WeatherWaterClimateServices/wwcs/WWCS/ews/README.md

# Parameterization in the SitesHumans.Sites table
'{"Heat1": 25, "Heat2": 27, "Heat3": 29, "Cold1": 0, "Cold2": -5, "Cold3": -10, "Warn Altitude": 3000}'
