WeatherWaterClimateServices/wwcs/WWCS/irrigation/appdata/Potato/README.md

Kc.csv - these are the Kc used in the very first Excel from ICARDA. They are currently used within the WWCS system.

The excels for plot 3 are more recent. Their Kcs corresond to a shorter growing period. Information from these files is not in the WWCS system so far, they are kept for information.
