WeatherWaterClimateServices/wwcs/WWCS/home/www/api-small.png

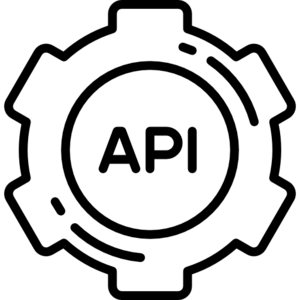
WWCS/home/www/api-small.png
