WeatherWaterClimateServices/wwcs/WWCS/home/www/api_small_border.png

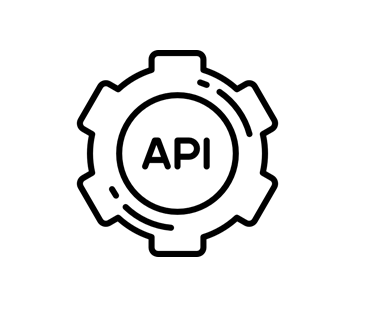
WWCS/home/www/api_small_border.png
