WeatherWaterClimateServices/wwcs/WWCS/home/www/cold-wave-small.png

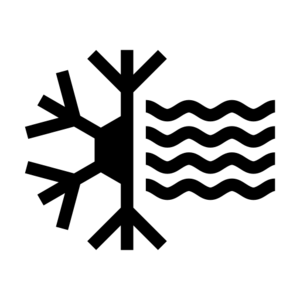
WWCS/home/www/cold-wave-small.png
