WeatherWaterClimateServices/wwcs/WWCS/home/www/harvest-small.png

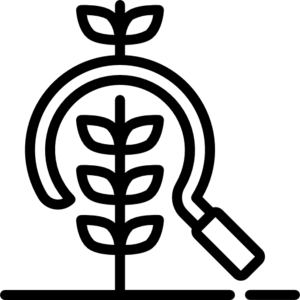
WWCS/home/www/harvest-small.png
