WeatherWaterClimateServices/wwcs/WWCS/home/www/monitor-small.png

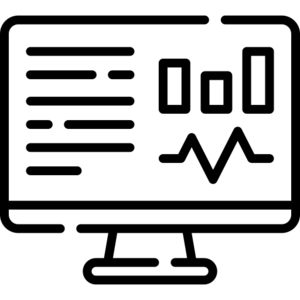
WWCS/home/www/monitor-small.png
