WeatherWaterClimateServices/wwcs/WWCS/home/www/planting-small.png

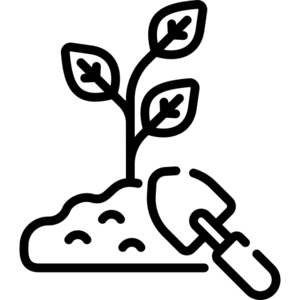
WWCS/home/www/planting-small.png
