WeatherWaterClimateServices/wwcs/WWCS/home/www/water-system-small.png

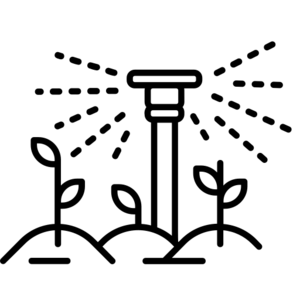
WWCS/home/www/water-system-small.png
