WeatherWaterClimateServices/wwcs/WWCS/irrigation/appdata/Cotton/Growing cycle Cotton Page 106 FAO56.png

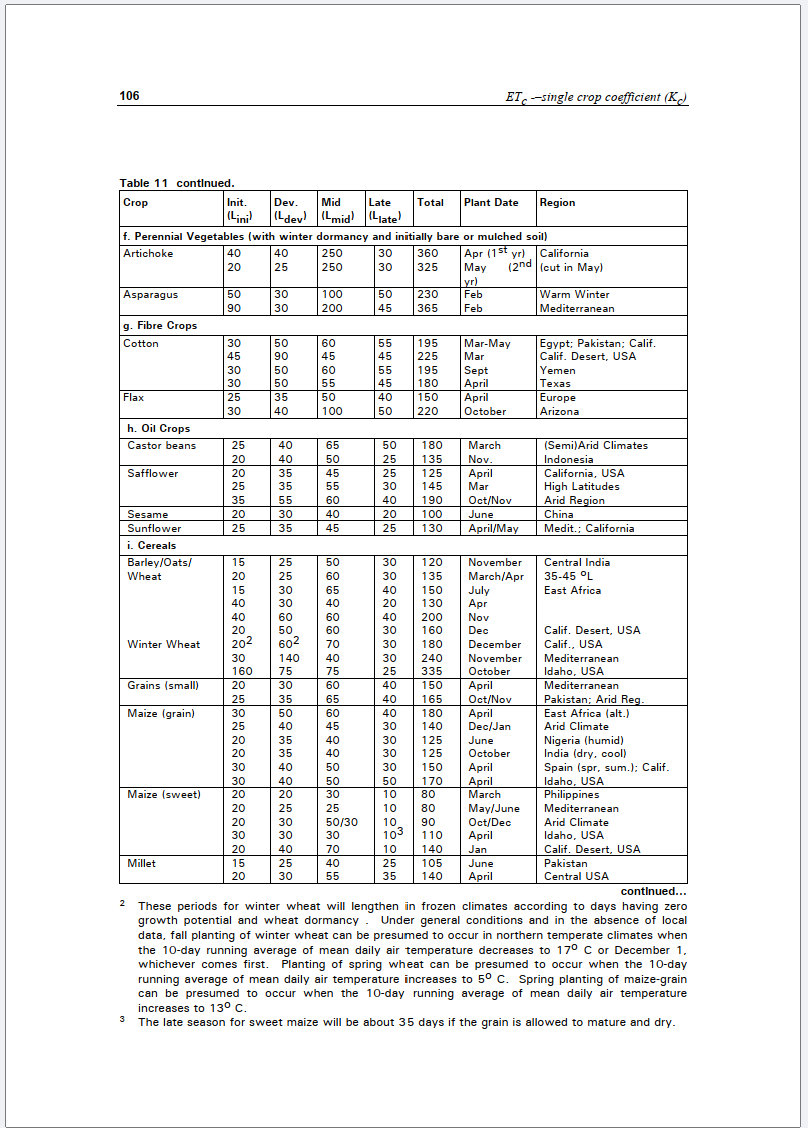
WWCS/irrigation/appdata/Cotton/Growing cycle Cotton Page 106 FAO56.png
