WeatherWaterClimateServices/wwcs/WWCS/irrigation/appdata/Cotton/Max rooting depth Cotton FAO 56.png

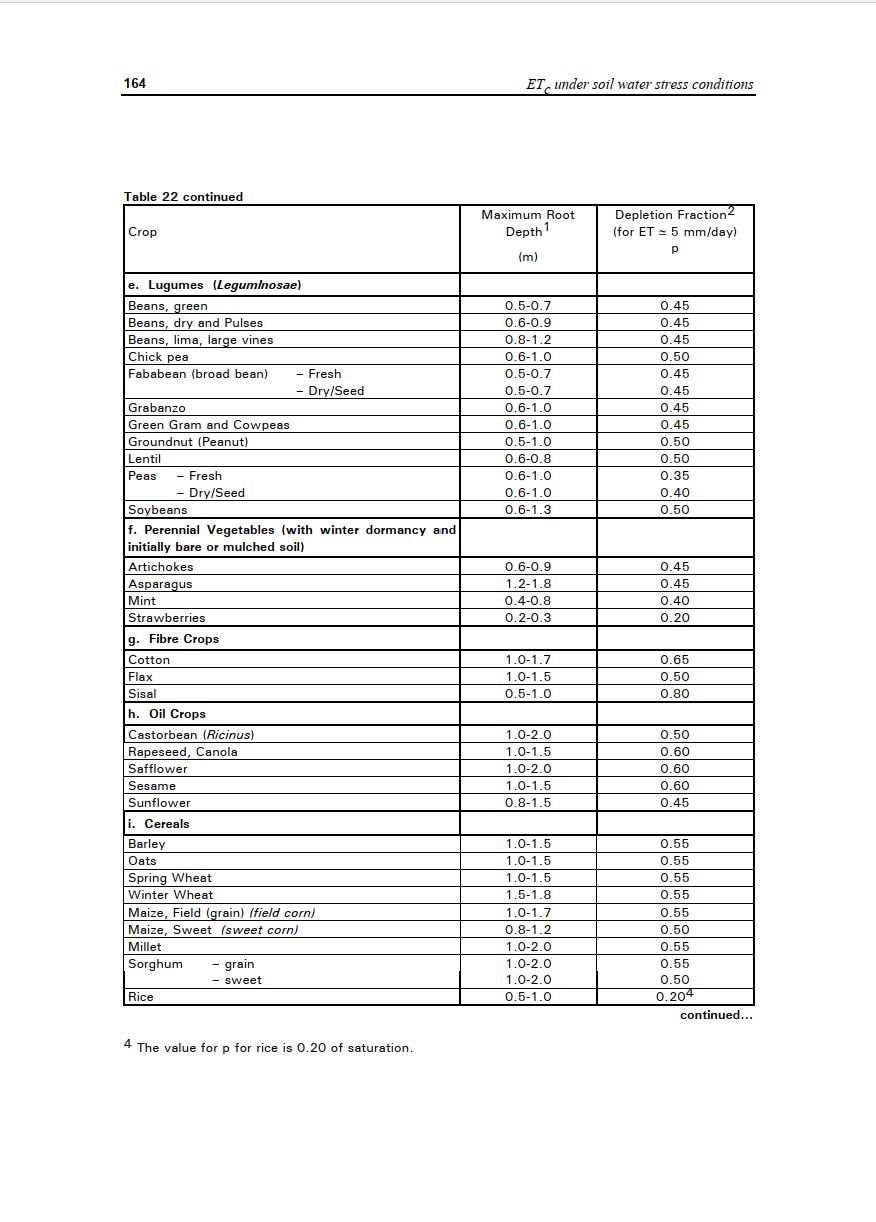
WWCS/irrigation/appdata/Cotton/Max rooting depth Cotton FAO 56.png
