WeatherWaterClimateServices/wwcs/WWCS/irrigation/appdata/Cotton/Page 111 FAO56.png

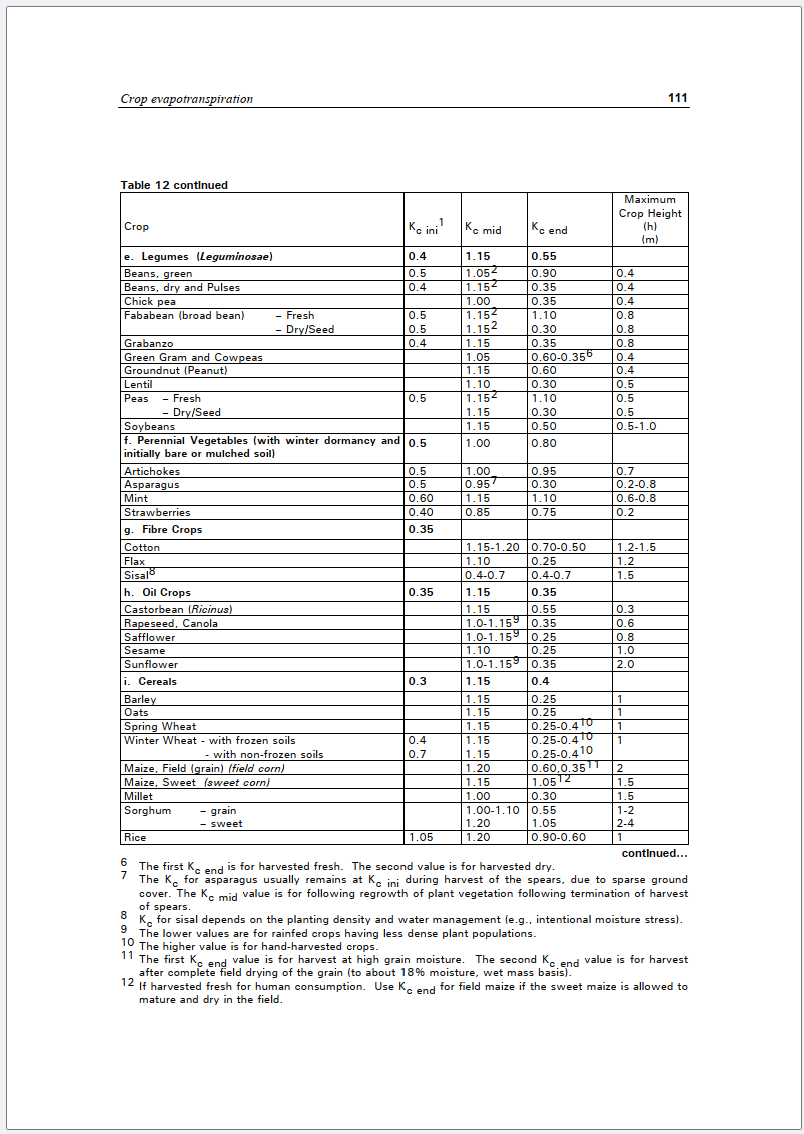
WWCS/irrigation/appdata/Cotton/Page 111 FAO56.png
