WeatherWaterClimateServices/wwcs/WWCS/irrigation/appdata/WinterWheat/Kc Winter Wheat .png

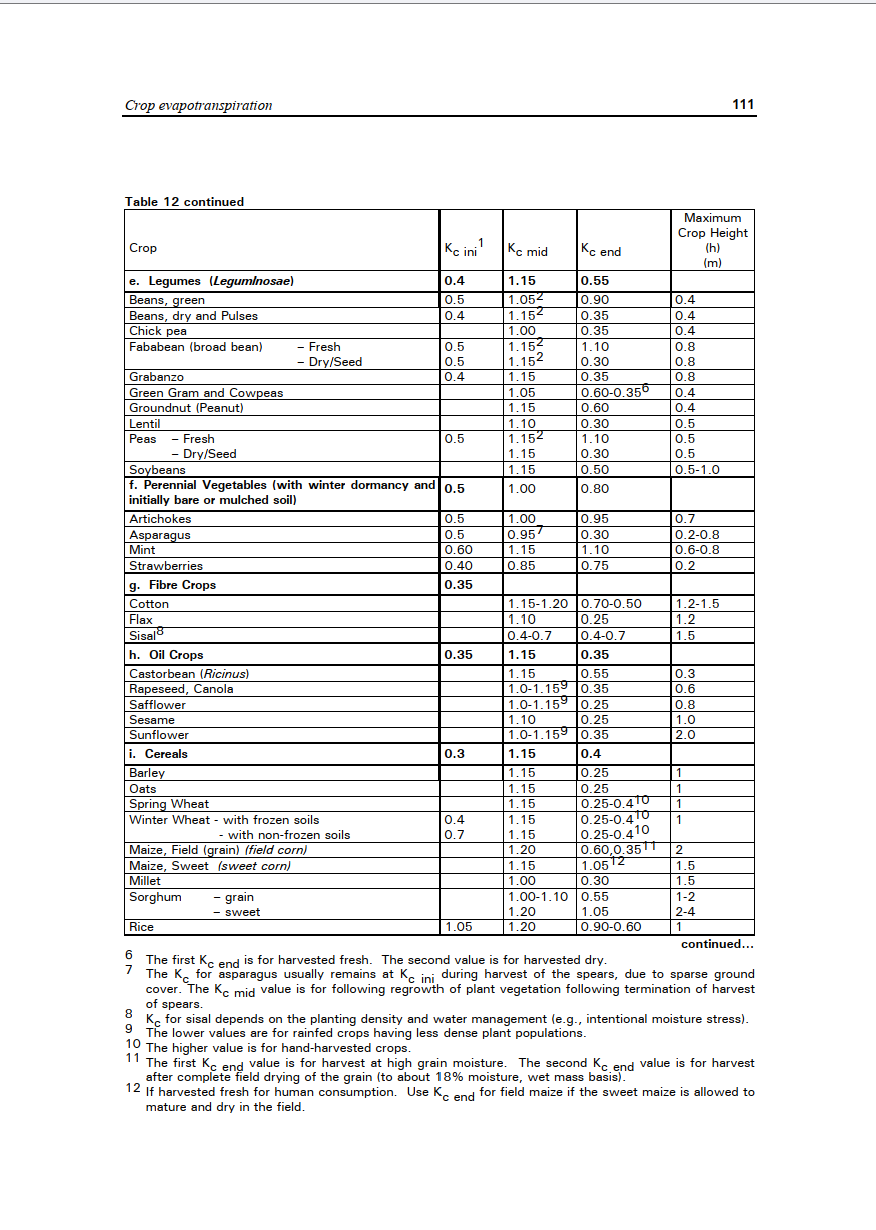
WWCS/irrigation/appdata/WinterWheat/Kc Winter Wheat .png
