WeatherWaterClimateServices/wwcs/WWCS/irrigation/appdata/WinterWheat/Max rooting depth Winter Wheat FAO56.png

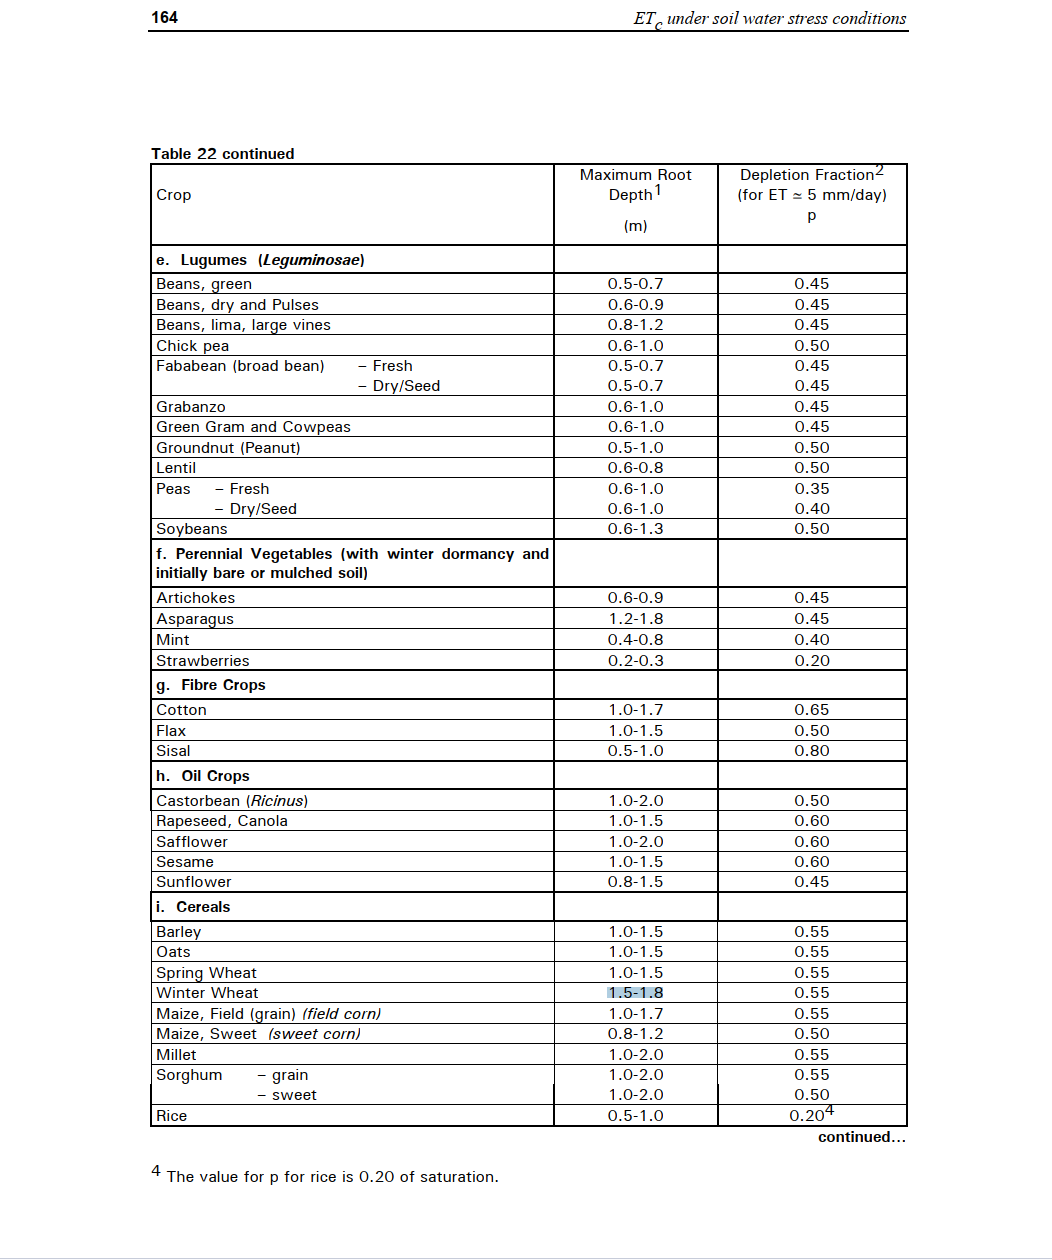
WWCS/irrigation/appdata/WinterWheat/Max rooting depth Winter Wheat FAO56.png
