WeatherWaterClimateServices/wwcs/WWCS/irrigation/appdata/WinterWheat/Max rooting depth Winter Wheat.png

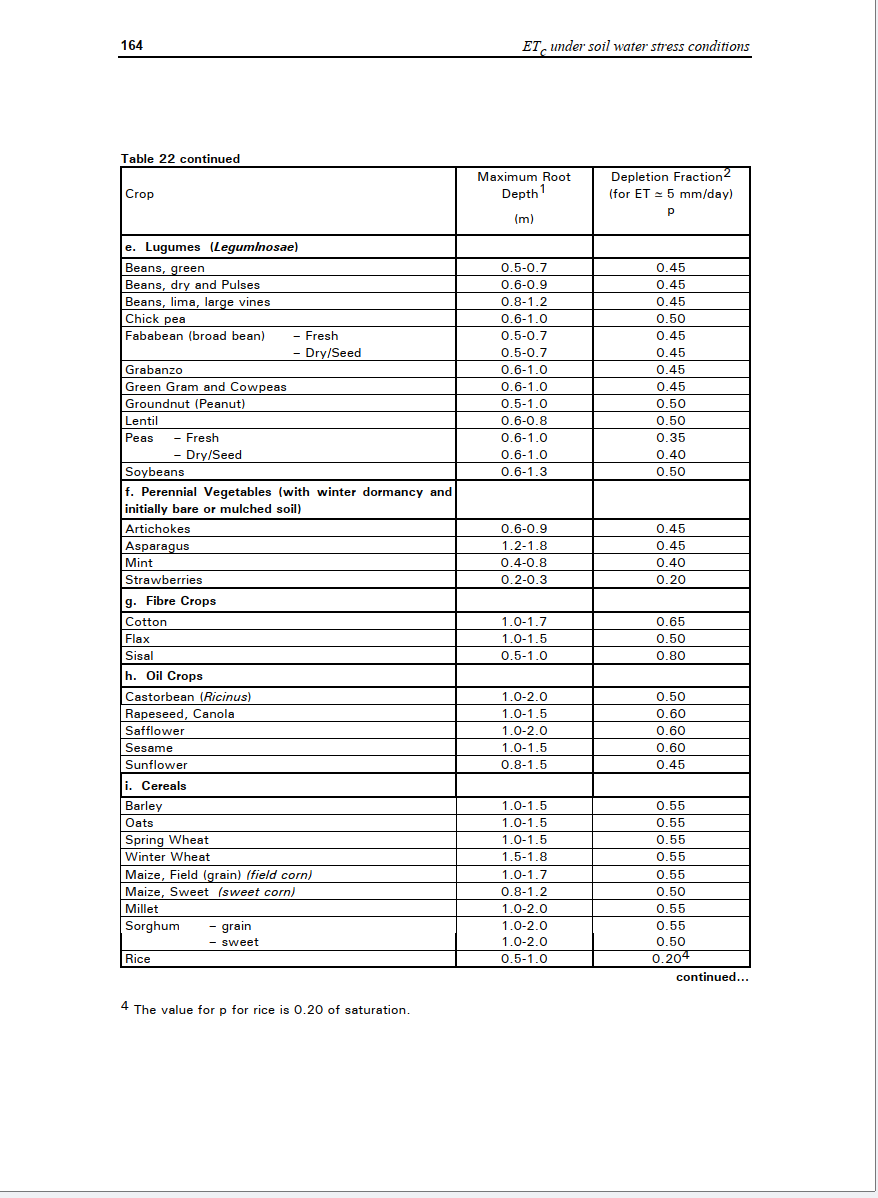
WWCS/irrigation/appdata/WinterWheat/Max rooting depth Winter Wheat.png
