WeatherWaterClimateServices/wwcs/Experimental/uploads/274c11eaea23f99c8101f92d145a69b3/solder_small.jpg

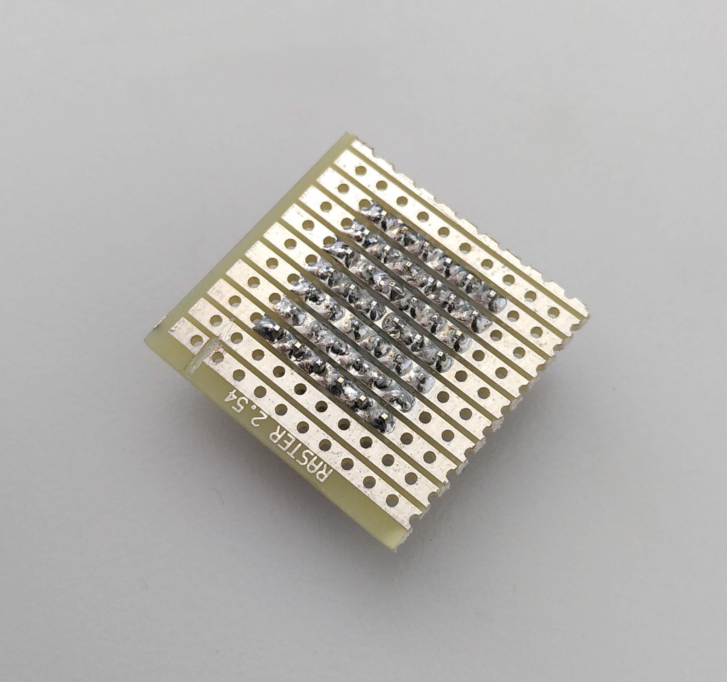
Experimental/uploads/274c11eaea23f99c8101f92d145a69b3/solder_small.jpg
