WeatherWaterClimateServices/wwcs/Experimental/uploads/756d3ad89f2d58e4a3ba79fbf11e7016/solder.jpg

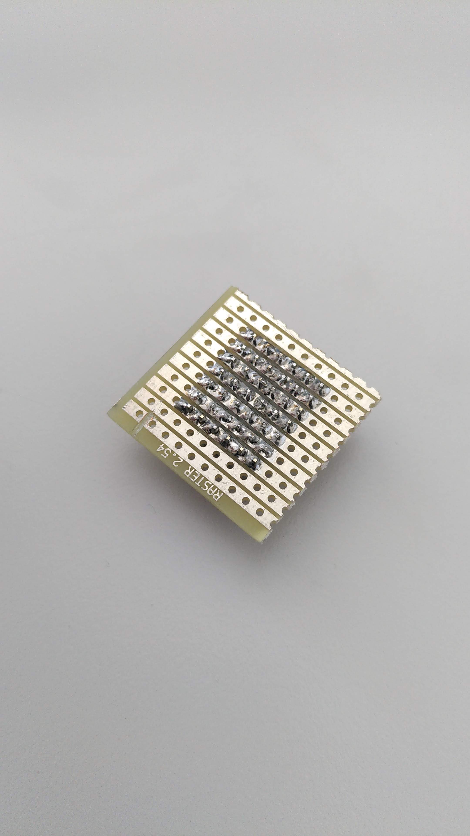
Experimental/uploads/756d3ad89f2d58e4a3ba79fbf11e7016/solder.jpg
