WeatherWaterClimateServices/wwcs/Experimental/README.md

This folder contains documentation and code for additional low-cost sensors, together with some early testing. These developments have been done by @bonamyr during work at SLF.
