WeatherWaterClimateServices/wwcs/Experimental/uploads/9176adec232814393722900b84b2ac1f/wwcs_devops_28032022.pptx

## Architecture

WWCS DevOps Meeting

Stations

WWC Services

Citizen Observations

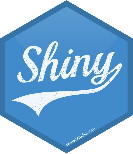
[picture p78: figure]
Shiny - R package | BIII
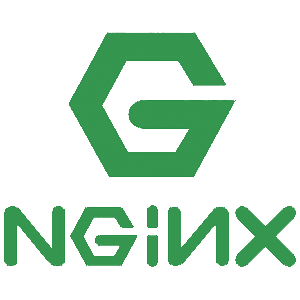
[picture p79: figure]
Nginx Web Server | Linux Destek Sunucu Yönetimi Danışmanlık & Eğitim
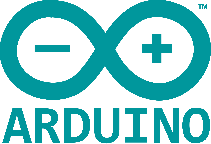
[picture p80: figure]
Datei:Arduino Logo.svg – Wikipedia

Frontend

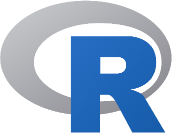
[picture p81: figure]
R (Programmiersprache) – Wikipedia
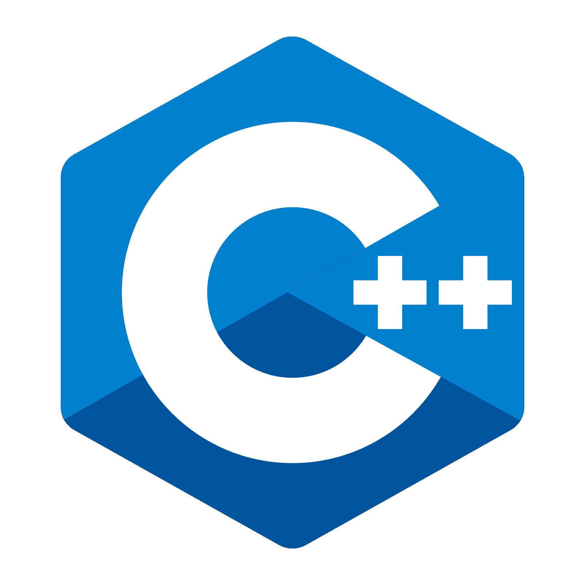
[picture p82: figure]
CONZEPT 16 C++-Schnittstelle - vectorsoft
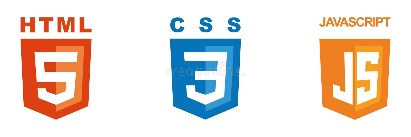
[picture p83: figure]
Ikonensatz HTML5 CSS3 JS Web-Entwicklungs-Logo-Ikonensatz HTML, Css Und Javascript, Programmierungssymbol Vektor Abbildung - Illustration von programmierung, java: 154897294
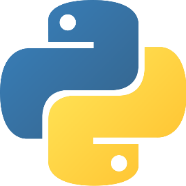
[picture p84: figure]
Datei:Python-logo-notext.svg – Wikipedia

Backend

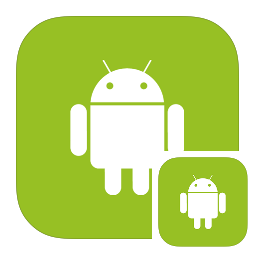
[picture p85: figure]
java - Strange app icon duplication in pinned shortcut (Android O) - Stack Overflow

API

API

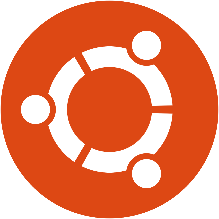
[picture p86: figure]
File:Logo-ubuntu cof-orange-hex.svg - Wikimedia Commons
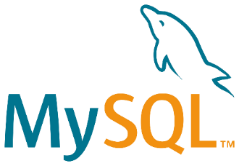
[picture p87: figure]
MySQL – Wikipedia
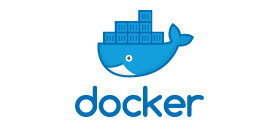
[picture p88: figure]
Was ist Docker? | AWS

Server

## Slide 2

WWC Services

| Dashboard | Kiosk | Maintenance Tool
Purpose | Check operations and identify problems of stations. Provide WWCS Services in a dashboard optimized for desktop computer. | Provide WWCS at district level in collaboration with agricultural advisors optimized for cash machine devices | Manage the deployment and maintenance of stations optimized for mobile devices.
Software | C++ for station processing Python + R for calculations based on MeteoSwiss scripts. R-Shiny to visualize the dashboard | Python + Microsoft Forms | Python + HTML (bootstrap) + JS
Focal Points | Omar, Mathias | Kushbakht, Safarali | Kushbakht, Safarali
Snapshot

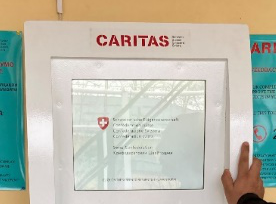
[picture p89: figure]
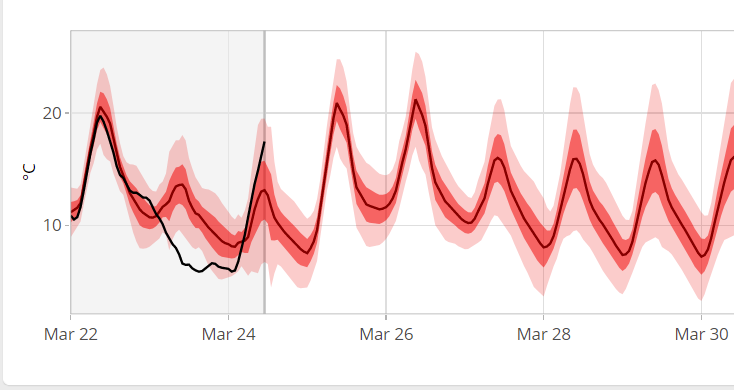
[picture p90: figure]
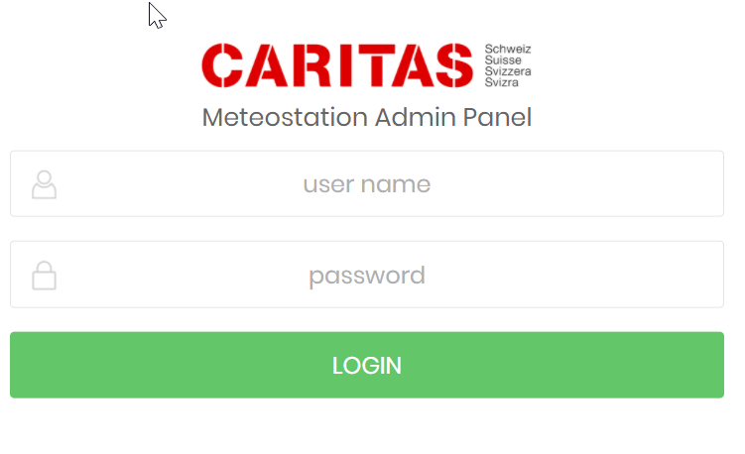
[picture p91: figure]

## Slide 3

Station Monitoring

Station Monitoring

WSL GitLab

Current Structure

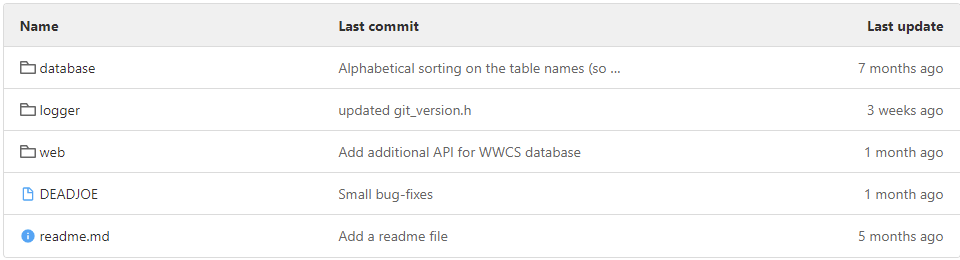
[picture p92: figure]

Kiosk

Proposed changes
1. Rename «logger» to «stations» to include also python scripts
2. Add folder «citizen» with the application that pushes the sms data
3. Rename «web» with «services»
Inside «services»:
  - «dashboard»
  - «kiosk»
  - «maintenance»
  - «API»
4. Create a «Dockerfile» for the container

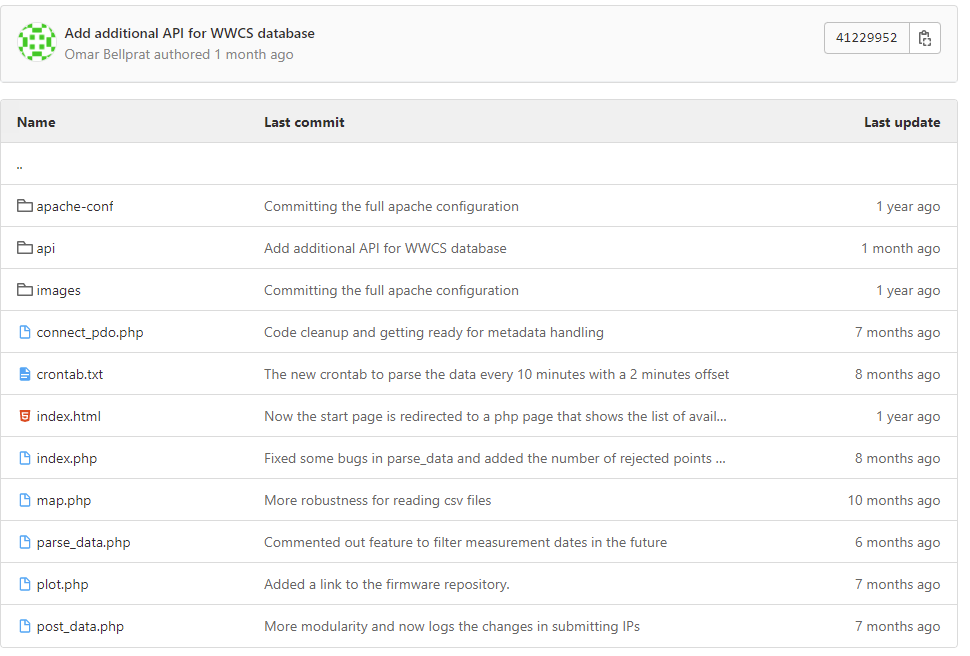
[picture p93: figure]

## Slide 4

List of tasks (GitLab Issues / Milestones)

1. Revise GitLab folder structure (Boris)
2. Push all developments to GitLab WWCS / Web (Omar, Kushbakht)
3. Milestone: Replace .PHP with .Python
  1. Issue: Rewrite post_data.php / parse_data.php / connect_pdo.php in python with MAC adressing checking and cryptographic key (Kushbakht).
  2. Issue: Replace monitoring functions map.php, plot.php, index.html into Shiny Dashboard (Omar).
4. Milestone: Develop python tool to push sketch on loggers using git revision number (Omar, Kushbakht)
5. Milestone: Develop a containerized version of the server with docker (Kushbakht)
6. Milestone: Development of WWC Services (Omar, ICARDA)
1. Issue: Include boundary layer as predictor in temperature forecasts (Omar)
  2. Issue: Develop cold wave predictions using logistic regression (Omar)
  3. Issue: Include MeteoIO for station filtering and collocation of forecasts (Omar, Mathias)
