WeatherWaterClimateServices/wwcs/Experimental/uploads/1febfca0420d76f15f2a4eed7fd4167d/WWCS_Database.drawio.png

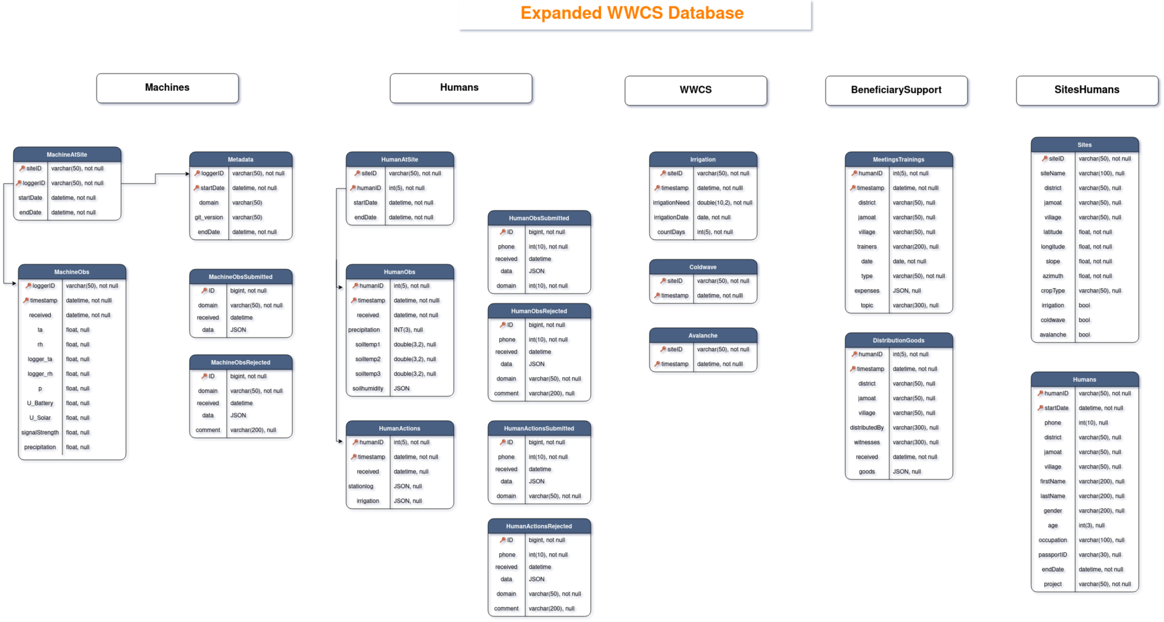
Experimental/uploads/1febfca0420d76f15f2a4eed7fd4167d/WWCS_Database.drawio.png
