WeatherWaterClimateServices/wwcs/Experimental/uploads/2ad0f96953296d475e2427b4fbd21ad4/wwcs_tj.jpg

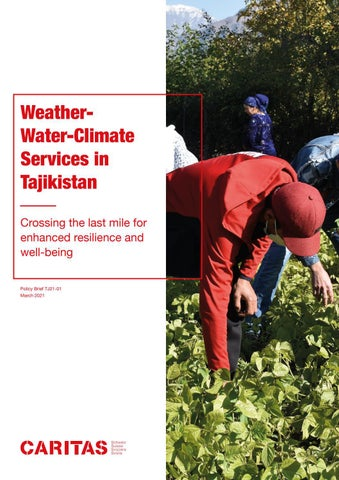
Experimental/uploads/2ad0f96953296d475e2427b4fbd21ad4/wwcs_tj.jpg
