WeatherWaterClimateServices/wwcs/Experimental/uploads/06bb7a899446780f2dc3899c71106170/calibr_distance.png

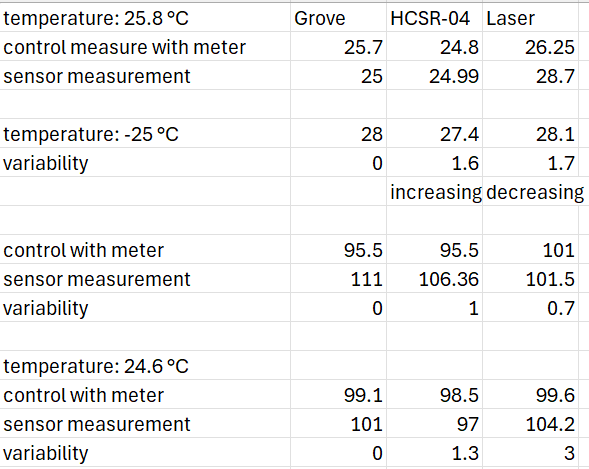
Experimental/uploads/06bb7a899446780f2dc3899c71106170/calibr_distance.png
