WeatherWaterClimateServices/wwcs/Experimental/uploads/508c6f5e7d339a3880c8139503f94f04/dist_calibration_meter.jpg

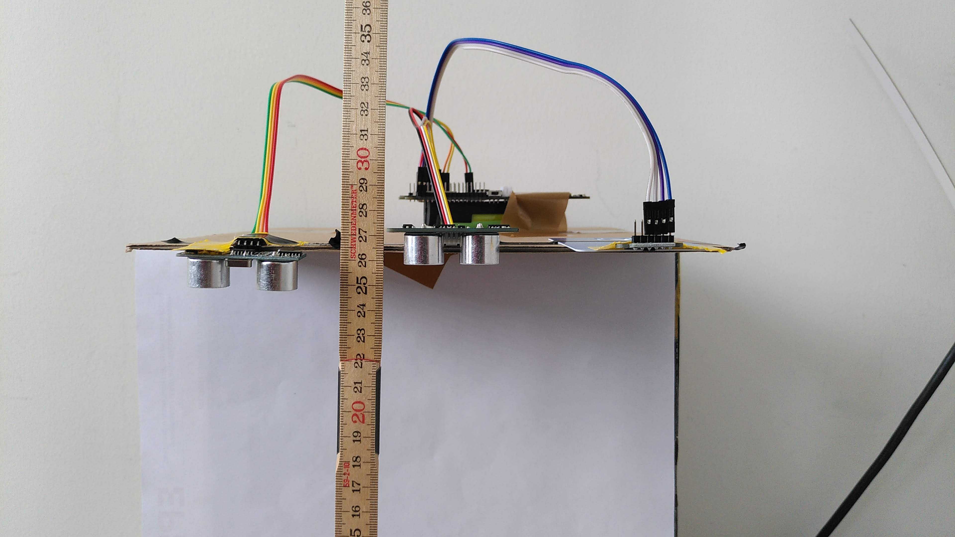
Experimental/uploads/508c6f5e7d339a3880c8139503f94f04/dist_calibration_meter.jpg
