WeatherWaterClimateServices/wwcs/Experimental/uploads/277219e93ca62fd4ee17841f8528d4ad/Dissemination.jpg

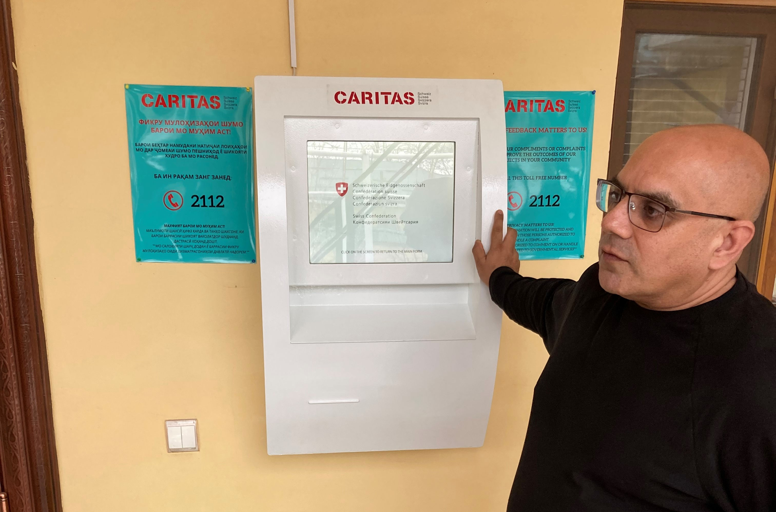
Experimental/uploads/277219e93ca62fd4ee17841f8528d4ad/Dissemination.jpg
