WeatherWaterClimateServices/wwcs/Experimental/uploads/d79ea830e73af7d5efae2f1a8cbccbcb/flashgordon.jpg

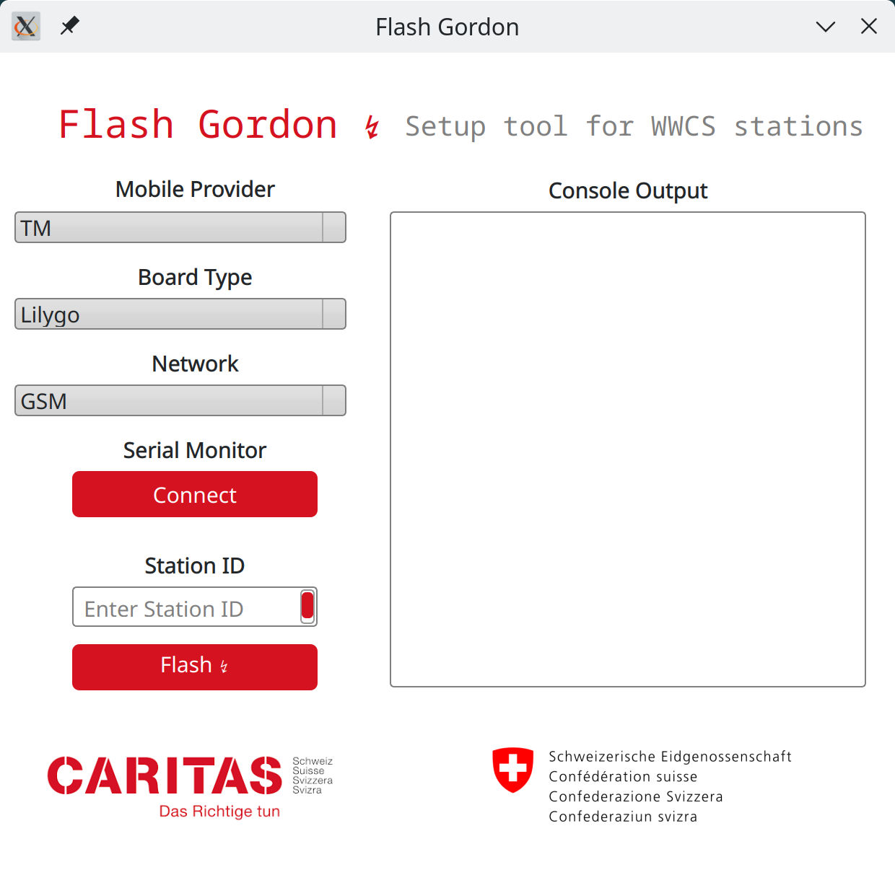
Experimental/uploads/d79ea830e73af7d5efae2f1a8cbccbcb/flashgordon.jpg
