WeatherWaterClimateServices/wwcs/Experimental/uploads/e3278ac66eda13e68dfb16a3a566d494/Screenshot_2022-08-25-13-26-57-460_com.example.irrigationmanager.jpg

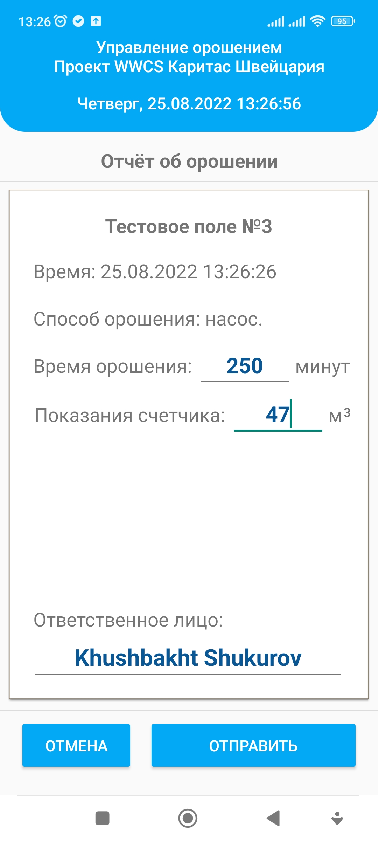
Experimental/uploads/e3278ac66eda13e68dfb16a3a566d494/Screenshot_2022-08-25-13-26-57-460_com.example.irrigationmanager.jpg
