WeatherWaterClimateServices/wwcs/Experimental/uploads/e14746c9a71a7227551538a29db0cc1b/wwcs-board__2_.jpg

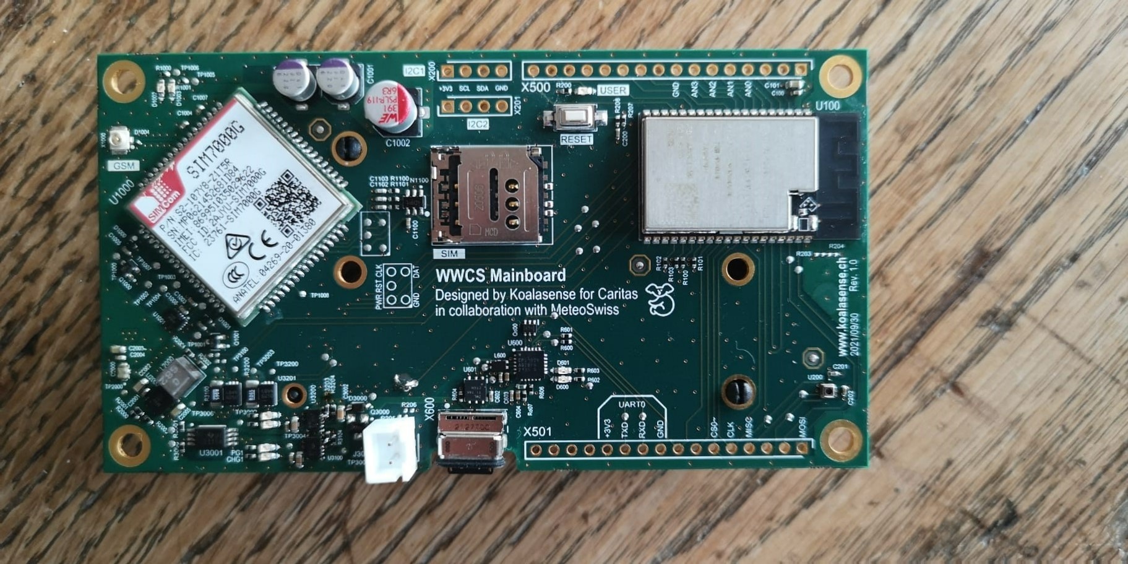
Experimental/uploads/e14746c9a71a7227551538a29db0cc1b/wwcs-board__2_.jpg
