WeatherWaterClimateServices/wwcs/Experimental/uploads/ec0c7cb5cba4ab000803f60d27f2690c/mlx_calibration.jpg

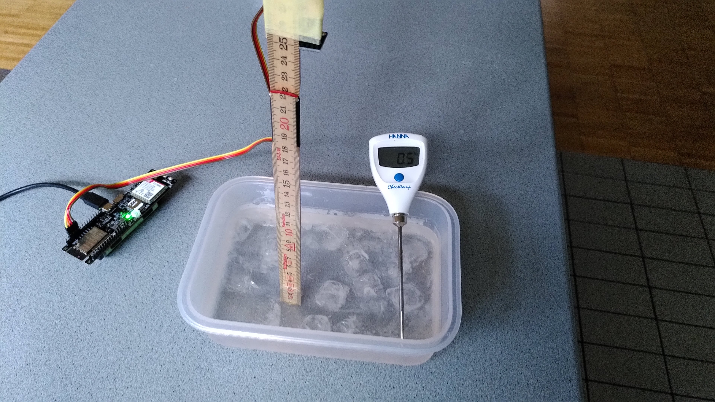
Experimental/uploads/ec0c7cb5cba4ab000803f60d27f2690c/mlx_calibration.jpg
