WeatherWaterClimateServices/wwcs/Experimental/uploads/fea11c49f9313b170b2b4deea4fe4907/dist_calibration.jpg

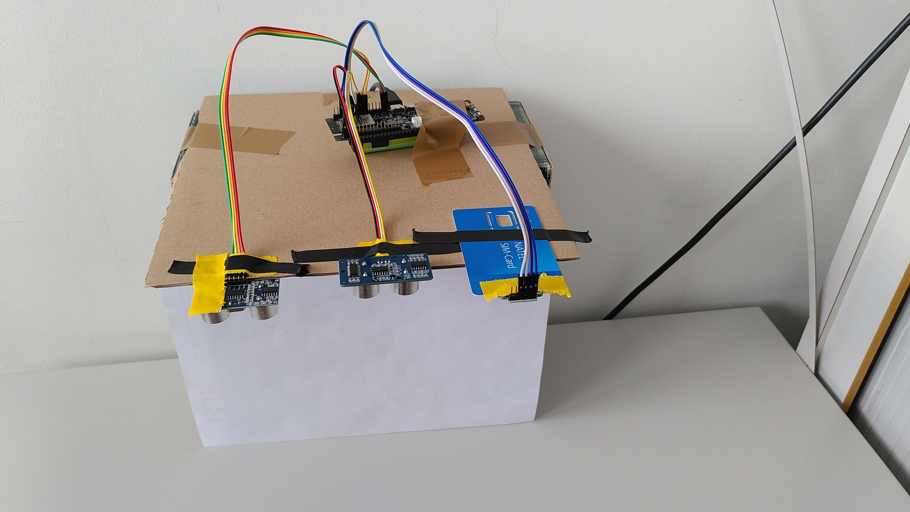
Experimental/uploads/fea11c49f9313b170b2b4deea4fe4907/dist_calibration.jpg
