WeatherWaterClimateServices/wwcs/Experimental/uploads/ff4de8d003f92d2ad08b40db15ac9ada/tsl_calibration.jpg

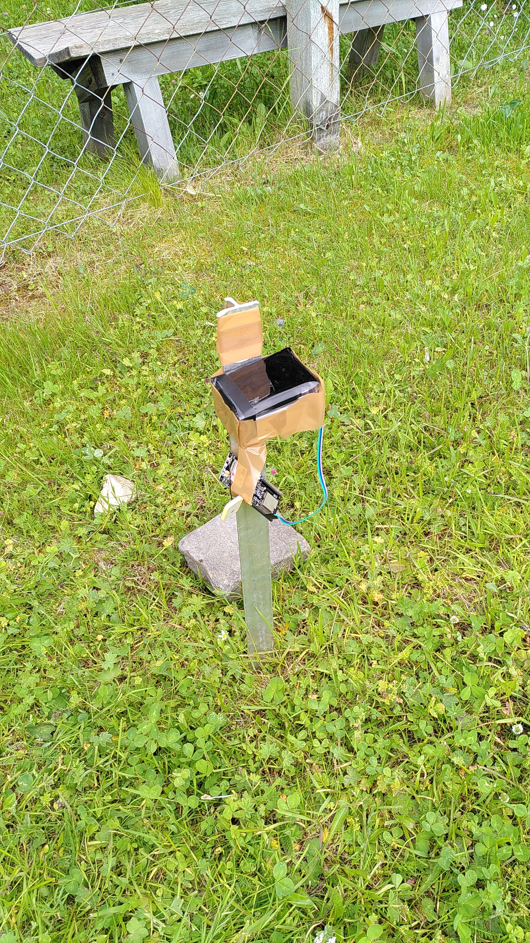
Experimental/uploads/ff4de8d003f92d2ad08b40db15ac9ada/tsl_calibration.jpg
