WeatherWaterClimateServices/wwcs/(threads)

Thread 3 (2025-03-14):

obsolete XX_Battery2 parameters

borlowsky, 2025-03-14:
the previous differentiation between the two batteries on the koalaboards is no longer there, and only the Battery1 parameters are available. In the plots of map (and elsewhere?) we don't need the select boxes for the Battery2 parameters. Can these be removed and Battery1 renamed to Battery in the display?
I was thinking of moving away from Battery1 everywhere, but the problem for now is that the existing stations in Taj submit these as Battery1; we either need to update them all, or have an additional check in the Tajik API which tests whether the JSON from the station contains Battery (from new stations, if we revise everything) or Battery1 (from existing entries). keeping as is and only adjusting the display would of course work but if we think of replications which start from scratch if feels better to have this harmonized. Any thoughts, incl on feasibility? Addressing this to both of you for feedback and joint understanding before any action.

jdavid, 2025-03-14:
Options:

(A) Update the front to remove the choice and display always Battery1 as Battery.
(B) Update the firmware v4 to upload the data as Battery instead of Battery1. Then in the front remove the choice and display both Battery1 and Battery as Battery.
(C) Equal to (B) plus, after all stations have been updated with the latest firmware, rename the column Battery1 to Battery. Then the update the front to just display Battery.

In all cases the old Battery2 data will remain in the database but won't be used.

I'm not sure it's worth the trouble, but should not be difficult either:

1. Updating the firmware should be trivial
2. Updating the front in R, I don't know. The get_ecmwf function of the API should be updated too (easy).
3. Then wait... until all stations are updated with the new firmware version.
4. Renaming the column in the database is simple as well.
5. Update again the front/api.

It would take a long calendar time to finish, but at the end this public repo would only have Battery, which I guess is cleaner.

Thread 10 (2025-04-12):

the fate of flashgordon

borlowsky, 2025-04-12:
Hi all,
on Safarali's computer the compilation of the sketch within flashgordon fails. This snippet from the error shown on the flashgordon console indicate to me that there is a mismatch of versions:

Multiple libraries were found for \\"SSLClient.h\\"\\n Used: C:\\\\Users\\\\syatimov\\\\Documents\\\\Arduino\\\\libraries\\\\SSLClient\\n Not used: C:\\\\Users\\\\syatimov\\\\Documents\\\\Arduino\\\\libraries\\\\GovoroxSSLClient\\n",\n "builder_result": {\n "build_path": "C:\\\\Users\\\\syatimov\\\\AppData\\\\Local\\\\Temp\\\\arduino\\\\sketches\\\\

To accomodate the breaking changes in the esp32 core when jumping to ver 3.0.x, we exchanged the SSLClient library, and it seems that Safarali has still the previous SSLClient installed (presumably from an outdated installer?) which creates now this ambiguity. When was the last installer built? I believe that Safarali did not build the installer himself recently. Can the installer remove all installed libraries first to avoid this confusion?

A few comments:
- the ESP32 core version is hardcoded, but this should be specified in the libraries version json, since this is critical for the interplay with the library versions: https://github.com/WeatherWaterClimateServices/wwcs/blob/0c72726b98fae8d7b55dafd7a83f38c9da2288a4/Station/FlashBoard/flashgordon.py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 (the code requires 3.0.5, but on Safarali's computer it seems to 3.0.4 which is installed: "used_libraries": [\n {\n "name": "LittleFS",\n "author": "-",\n "maintainer": "-",\n "sentence": "LittleFS for esp32",\n "paragraph": "LittleFS for esp32",\n "category": "Data Storage",\n "architectures": [\n "esp32"\n ],\n "install_dir": "C:\\\\Users\\\\syatimov\\\\AppData\\\\Local\\\\Arduino15\\\\packages\\\\esp32\\\\hardware\\\\esp32\\\\3.0.4\\\\libraries\\\\LittleFS",\n ")
- the server url is hardcoded. Application in Uzbekistan and Cambodia is limited thereby
- the firmware does not come from git but from a manually (? or is there a cronjob?) created zip on wwcs.tj. This step is not documented, and the folder where this zip lives has a rather individual name https://github.com/WeatherWaterClimateServices/wwcs/blob/0c72726b98fae8d7b55dafd7a83f38c9da2288a4/Station/FlashBoard/flashgordon.py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

Based on these, if we go forward with flashgordon, additional features should be:
- an option to specify the URL
- an option to enter the APN of the mobile provider manually; otherwise we have to revise the code for every replication outside of Taj

All in all the use of this tool so far requires too much of expert finetuning for application at scale, but if the points in these issue would be all it takes to make it fully functional it may be worth the effort. The only point I find not so ideal is the zip for the firmware. Why did you not want to pull this from the git directly? After selecting the board, you would basically need one file only (the anchor files are all obsolete).

For Usbekistan I think we can in principle go without flashgordon, as these guys could handle both flashing from Arduino and updating the db. In any case the Site must be registered manually in the Sites table (coordinates etc), but for TJHM this is a required tool for field maintenance, and likely the same for future applications in other regions.

Could you give your perspective on the above points, and how much effort this would be?

obellprat, 2025-04-16:
@jdavid can you please take care issue?

jdavid, 2025-04-25:
> the SD1-12 library is missing

I see you have added this in commit a79f493

I will look at the other issues.

Thread 11 (2025-04-12):

complete updating the MachinesAtSite when registering new board

borlowsky, 2025-04-12:
The API so far only registers a new station, but does not check whether the same loggerID has already been registered. In this case, that line should get the current date as EndDate. This is relevant if a logger is replaced or moved to another site, so that the v_machineobs view can concatenate the data correctly. So far, Safarali does this step manually.

https://github.com/WeatherWaterClimateServices/wwcs/blob/0c72726b98fae8d7b55dafd7a83f38c9da2288a4/API/api_station.py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

jdavid, 2025-04-25:
@borlowsky I've a question.

The tables look like this:

```
Machines.MachineAtSite
+-----------+-------------+---------------------+---------------------+
| siteID    | loggerID    | startDate           | endDate             |
+-----------+-------------+---------------------+---------------------+
| test-site | test-logger | 2025-04-25 13:46:19 | 2100-01-01 00:00:00 |
+-----------+-------------+---------------------+---------------------+

Machines.Metadata
+-------------+---------------------+---------------------+-----------+------------------+
| loggerID    | startDate           | endDate             | domain    | git_version      |
+-------------+---------------------+---------------------+-----------+------------------+
| test-logger | 2025-04-25 13:46:19 | 2100-01-01 00:00:00 | localhost | test-git-version |
+-------------+---------------------+---------------------+-----------+------------------+
```

If `test-logger` is registered again, do you expect a new row to be inserted into the `Machines.MachineAtSite` table only, or in both `Machines.MachineAtSite` and `Machines.Metadata` ?

borlowsky, 2025-04-27:
good point. I believe in both tables... the MachineAtSite is needed for the v_machineobs view to concatenate correctly, Metadata is used for debugging with we want to check whether a specific version of the firmware causes problems.

Thread 15 (2025-04-27):

clarify crop and site parameters,  insert checks if parameters are missing

borlowsky, 2025-04-27:
https://github.com/WeatherWaterClimateServices/wwcs/blob/1865e642406f87304bb50e27acea6ffd71651386/WWCS/irrigation/server.R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

If the expected parameters cannot be read from the db, this crashes silently.

Furthermore, not clear that all queried parameters are needed, or that all needed parameters are queried from the right source.

MAD should be  a crop parameter (separate issue, for now a site parameter).

Unclear whether we need WA.

We need the siteID of the used weather station, as well as IE (irrigation efficiency).
