WeatherWaterClimateServices/wwcs/(commit log)

2024-12-16 Correct bug in Battery name WWCS Map
2025-03-28 added CropParameters.csv to contain Kc and rooting depths for various crops; and an R script to generate them
    [CropParameters.csv]
2025-04-12 re-inserted a lost linebreak to include esp_err.h
2025-04-12 updated required_libraries.json, both for Koala04 and Flashgordon. These libraries are all at the current version and tested to work well with esp32 core 3.2.0
2025-04-23 introduced linear interpolation for ETc in case of gaps within the series
2025-04-27 added additional crops, and created subfolders (per crop) to store the sources from where the parameters have come
    [Cotton_Kc_Only.xlsx, CropParameters.csv, Irrigation_Soil_Moisture_Managment Plot Traditional (Ea = 50%) Cotton.xlsx, Irrigation_Soil_Moisture_Managment Plot Traditional (Ea= 50%)Winter wheat.xlsx, Irrigation_Soil_Moisture_Managment Plot laser-levelled (Ea = 65%) Winter wheat.xlsx, Irrigation_Soil_Moisture_Managment Plot laser-levelled (Ea=65%) plot Cotton.xlsx, Irrigation_Soil_Moisture_Managment 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]
2025-05-06 updated version number for esp32 core
2025-05-06 bot: translate buttons (wip)
2025-05-06 Harmonize irrigation frontend with backend developments from the generation of crop parameters
    [CropParameters.csv]
2025-05-06 Generate crop parameters with read and write rights for shiny user
    [CropParameters.csv]
2025-05-06 Skip irrigation at site if start date is in year before the current one
2025-05-15 Update bot.py
    Add BUTTONS dictionary at line 153. This is the way how to internationalize buttons and translate them
2025-05-15 Update messages.po
    Translate buttons
2025-05-16 added parameterization for Cucumber, with 2 months growing period as in Cambodia
    [Estimated_Rooting_Depths.csv]
2025-05-17 Update messages.pot
    add tajik translation to buttons
2025-05-23 downgraded versions for esp32 core and the SDI12 library. while the most recent versions work on a linux laptop, they did not read out the climavue50 when compiled on safarali's windows laptop.
2025-05-23 updated crop parameters for CucumberCambodia (60 days growing period)
    [CropParameters.csv]
2025-05-26 irrigation: changed server.R to read available crop configuration from CropParameters.csv, and removed the default selections for crop and type - these had led to unintended overwrites in the Sites t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
2025-05-28 Reduced time frame for smart met API retrieval
2025-05-30 Update bot.py
    add new logic for pump and counter fieldtypes
2025-06-07 updated CucumberCambodia for initial days in the nursery
    [CropParameters.csv]
2025-06-08 Update bot.py
    Fixed Save data button for channel type
2025-06-13 added cambodian tomato, with 45 days in nursery
    [CropParameters.csv]
2025-06-16 differentiated Cambodian Cucumber for direct seeding and transplanting after some time in nursery
    [CropParameters.csv]
2025-06-18 wwcs.conf - removed lines which are automatically inserted by certbot, as these will depend on the url
2025-06-27 updated parameters for TomatoCambodia - Kcs were way too high changed from xlsx to readxl library, to avoid tricky dependency on rJava
    [CropParameters.csv]
2025-07-04 treated the case where PHIc < WP; and checked that initial PHIc from HumanSites.Sites is between WP and FC - break otherwise.
2025-07-04 bug-fix: include type = WWCS filter for the irrigation table corrects the correct manual editor
2025-07-04 refactor: Remove printing commands used to debug last commit
2025-07-04 updated CucumberCambodia Kc values
    [CropParameters.csv]
2025-07-04 irrigation_calculation: inserted a first aggregation to 3hr timesteps of the stations data before aggregating to daily, to ensure a minimum full diurnal cycle
2025-07-10 Update bot.py
    1. translated all comments from russian into english.
    2. Deleted No water button.
    3. Changed buttons name to Start Irrigation and Irrigation finished also in message handlers.
    4. In get_irrigation_data function in SQL script add new measurement_device as device (in Sites table in fieldproperties column we need to add measurement_device parameter).
2025-07-11 updated RDs for CucumberCambodia*
    [CropParameters.csv]
2025-07-11 another update to CucumberCambodia* RDs... likely not the last.
    [CropParameters.csv]
2025-07-17 added Kc and RD for PintoBeans, and adjusted Cucumber and Tomato for Cambodia
    [CropParameters.csv]
2025-07-22 Update bot.py
    1. Added conditions for control and treatment plots with three type of devices
    2. Added new save_irrigation_data function (in some places i used this function just to check.)
    3. new message handler waiting_for_water_level_control was added
    4. Also other message handlers was amended (according to Boris flow that he sent)
2025-07-28 Drop Battery2 columns
2025-08-22 Update bot.py
    1. Remove the “Select action” message after the /start command
    2. Add 0 value in WATER_FLOW_RATES dictionary
    3. added a reset of the user_irrigation_data at the beginning of a new irrigation session Line:403
2025-08-23 irrigation: inserted a catch for NA water balance (e.g. because of station downtime); this will now write NA/NULL into the db for irrigationNeed
2025-09-10 bot don't display buttons after "technical problem" error
2025-09-10 Update bot.py
    line 516 structured as was required:
    'type': 'control',
    'device': 'thomson_profile',
2025-09-16 Update bot.py
    case PHIc > PHIt was moved to check_irrigation function
2025-09-22 Update bot.py
    Removed finally block that incorrectly reset user state on every execution. State now resets only on successful completion or critical exceptions. Maintains state for logical errors (end <= start) for correct re-entry (in waiting_for_counter_end handler)
    Also in irrigation_finished handler removed (else condition) in control and treatment type with incremental_meter device
2025-09-24 Update bot.py
    add conditions in treatment and control types for incremental_meter device if user push Irrigation finished button instead Start irrigation button
2025-09-29 Update bot.py
    In Start irrigation and Irrigation finished handlers for device = incremental_meter for control and treatment types condition was added in one
2025-09-29 Update bot.py
    Also for total_meter device conditions for control and treatment was changed into one
2025-09-29 Update bot.py
    In the beginning for control type with thomson_profile device save message was different then others. Now insert changes and now all save messages are the same
2025-09-29 koala04: added printout of IMEI for registration
2025-10-02 Add possibility to switch on and off pw for WWCS applications in config.yaml
2025-10-02 Consider case where use_pass is not defined in the config.yaml
2025-10-09 Update bot.py
    check for 'type' was removed for "incremental_meter" device and also for "total_meter" device was removed check for "type" in handle_recommendation function.
2025-10-23 added new WinterWheatUzbekistan parameters
    [CropParameters.csv]
2025-11-12 added manuals for station assembly
    [ComponentsLowCostWeatherStations.xlsx]
2025-11-12 Update README.md: reference to manuals for station assembly
2025-12-05 flashgordon: update to latest arduino-cli
2025-12-12 Rename Charge/Temp Battery1 to Battery
2026-01-12 FirmwareKoala04: changed default transmission interval from 30 to 10min; renamed battery voltage to U_Battery (instead of U_Battery1)
2026-01-21 irrigation: added a missing filter for the sites table
2026-02-02 irrigation: new Kc for winter wheat according
    [CropParameters.csv]
2026-02-02 added omar's first draft on open-meteo (single locations temperature)
2026-02-06 EWS: minor corrections in preprocessing, removal of HSURF as predictor (private ECMWF file);
    [config_tajikistan.yaml]
2026-02-09 planting: added check to ensure current temperature to be used for recommendation
2026-02-09 planting: in service added 'next' in case no forecast data because of station down
2026-02-13 pictos: added look-up-table and made filename typofree
    [look_up_table.csv]
2026-03-03 EMOS.R & process_pictos.R: respond to the joint processing of ifs_ and ifs_extended; and the hourly timesteps which OM provides
2026-03-04 added additional crops for irrigation
    [CropParameters.csv]
2026-03-12 Update bot.py
    Change notification logic to send messages on-demand for non-stress and control plots
    - Add user_pending_recommendations dictionary to store messages for users who shouldn't receive automatic notifications
    - Modify check_irrigation function to only auto-send messages for treatment plots with water stress (phic <= phit)
    - Store recommendation data for treatment plots without water stress and all control plots
    - Update handle_recommendation to check for and send pending recommendations when user presses "Start Irrigation"
    - Control plots now only receive messages after pressing "Start Irrigation" button
    - Treatment plots without water stress now receive messages on-demand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
2026-03-14 client.py: inserted key-dependent url
2026-03-17 Update bot.py
    - Add keyboard to /start command welcome message
    - Buttons now appear consistently for users not found in system, database errors, and already registered irrigation cases
2026-03-20 corrected typo in config_tchad.yaml
    [config_tchad.yaml]
2026-04-24 dashboard: added restart.txt and a touch to cronjob_wwcs, to force display of current data
2026-04-30 Update bot.py
    add new measurement device "chipoletti" and new properties chipoletti_width. created function calculate_chipoletti_flow_rate and fixed bug user_pending_recommendation
2026-05-13 koala04: added code for SDS011 airquaility and tipping bucket raingauge
2026-05-13 koala04: switched to ntp datetime rather then gsm network time (not avail. everywhere)
2026-05-19 README: update to reflect the post-init stage
2026-05-20 dashboard: filtered relevant columns from data import in global.R to release RAM
2026-05-27 forecast/ews: removed obsolete filter for soil-temp-only stations and replaced by forecast=1
2026-06-06 koala04: enabled external wakeup conditional on TippingBucket==true to avoid wakeup from noise
    [FirmwareKoala_rev4.0.ino]
2026-06-06 koala04: relaxed condition on batV to cover case of broken bat sensor
    [FirmwareKoala_rev4.0.ino]
2026-06-13 koala: brought back tipping bucket and sds011; added teardown_modem()
2026-06-16 map: changed station-filter from ready/late to basic/climavue/airq
2026-06-22 Create README.md for firmware documentation
    Added detailed information about supported sensors and firmware configuration options.
2026-06-23 get_wwcs: caught the case of empty data; made the aggregation much faster
2026-06-30 Update api_wwcs.py
    added two new API's for air quality.
    GET /airquality/stations → 6 rows, latest reading + AQI per station
    GET /airquality/history?hours=24 → all readings last 24h for charts
2026-07-10 irrigation: added panicum grass parameters
    [CropParameters.csv]
2026-08-07 irrigation: added parameters for artemis95 potato
    [CropParameters.csv]
2026-08-07 CI: pin ruff to 0.15.22
    Version 0.16 enables many new rules
2026-08-31 dashboard: make timeranges reactive
2026-08-31 fix(api_station): fall back to client IP when reverse DNS fails
    get_domain() raised socket.herror for station IPs without PTR records
    after nginx started forwarding X-Forwarded-For. Catch the exception
    and return the raw client IP instead of crashing with 500.
2026-08-31 fix(firmware): check serializeJson return value
    Validate the size returned by serializeJson() in FirmwareKoala_rev4.0.ino
    for transmission, flash storage, and RTC storage. Records that serialize
    to an empty string or exceed the destination buffer are now skipped or
    logged instead of being sent/stored as empty or truncated JSON.
    [FirmwareKoala_rev4.0.ino]
2026-08-31 fix(firmware): guard against empty HTTP body in send_data_to_server
    Add a defensive null/empty check at the top of send_data_to_server().
    If the payload is empty, log and return true so the record is discarded
    instead of sending an empty POST /insert body.
    [FirmwareKoala_rev4.0.ino]
2026-08-31 style(firmware): replace tabs with spaces in FirmwareKoala_rev4.0.ino
    Convert remaining tab characters to spaces (tab width 2) for consistent
    indentation. No functional changes.
    [FirmwareKoala_rev4.0.ino]
2026-08-31 new weather icons for wmo codes
    [look_up_table.csv]
2026-08-31 fix(firmware): handle corrupted RTC JSON and recover from counter mismatch
    Check the return value of deserializeJson() when reading storedJSON from
    RTC memory. If parsing fails, clear the document and reset the counter.
    When transmRecordsJSON.size() and loopCounterTransm disagree, clear
    storedJSON and reset the counter instead of getting stuck forever.
    Add a TODO noting that loopCounterTransm is redundant with
    transmRecordsJSON.size() and could be removed in a future refactor.
    [FirmwareKoala_rev4.0.ino]
2026-08-31 fix(firmware): add missing return in connect_to_network
    connect_to_network() could reach the end of the function without
    returning a value when the second gprsConnect() attempt on first boot
    failed. Add return false to satisfy -Werror=return-type.
    [FirmwareKoala_rev4.0.ino]
2026-08-31 fix(api,db): avoid rejected-table bloat from empty station bodies
    With over 200 deployed stations, old firmware will keep sending empty
    POST /insert bodies for some time. These carry no useful debugging
    information and would fill Machines.MachineObsRejected too quickly.
    - In API/api_station.py: keep logging empty/invalid bodies, but only
    store non-empty malformed payloads in MachineObsRejected.
    - In API/test_api_station.py: update tests so empty bodies do not
    create a rejected row, while non-empty invalid JSON still does.
    - Add migration 0013 to drop the json_valid CHECK constraint on
    Machines.MachineObsRejected.data so that arbitrary malformed
    payloads (including non-JSON strings)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
2026-09-02 refactor(api_station): use distinct response codes for /insert outcomes
    - Return 201 for successful insertions.
    - Return fake 2xx codes 240/241 for permanent client errors so
    stations move on, while keeping codes distinct in logs.
    - Return 200 for duplicate data (idempotent success).
    - Return 500 for temporary server errors so stations retry.
    - Store invalid/empty JSON and validation failures in
    MachineObsRejected; do not store temporary 500 failures.
    - Update tests to match new status codes.
2026-09-02 Various improvements to FirmwareKoala_rev4.0.ino
    - Check return of deserializeJson
    - Reset state if transmRecordsJSON.size() != loopCounterTransm
    - Check return of serializeJson
    - Add guard in send_data_to_server to avoid sending empty payloads
    - Add missing return in connect_to_network (otherwise build may fail)
    - Style: use spaces instead of tabs
    [FirmwareKoala_rev4.0.ino]
2026-09-02 refactor(firmware): remove loopCounterTransm, use transmRecordsJSON.size()
    The loopCounterTransm counter was redundant with transmRecordsJSON.size()
    and created a failure mode where a mismatch between the two could leave
    the station stuck.
    - Remove RTC_DATA_ATTR loopCounterTransm.
    - Use transmRecordsJSON.size() for the transmission trigger and status.
    - Use transmRecordsJSON.add() to append new records.
    - Ensure transmRecordsJSON is an array after deserialization; recover
    from corrupted or non-array RTC data by clearing and converting.
    - Remove the confusion/mismatch branch entirely.
    [FirmwareKoala_rev4.0.ino]
2026-09-02 firmware(koala): treat 4xx /insert responses as permanent rejections
2026-09-02 firmware(lilygo): treat 4xx /insert responses as permanent rejections
2026-09-04 API insert check loggerID before timestamp
2026-09-04 API insert log warning on reject frame
2026-09-18 irrigation: error in case of bad parameters in fieldproperties; bugfix in filter for SQL_df (irrigation sites only everywhere)
2026-09-18 dashboard: caught case of wrong default station; added siteID to panel
2026-09-18 irrigation: caught case of wrong default station; added siteID to panel
2026-09-18 ews: caught the case of wrong default station
2026-09-18 planting: caught case of wrong default station
2026-09-18 harvest: caugt case of wrong default station; added siteID to panel if no data
2026-09-22 API: use WWCServices_DEV when ENV != PROD, unify DB access
    - common.py: centralize ENV switch (mirrors the R side: ENV=="PROD" ->
    WWCServices, otherwise WWCServices_DEV) and build both DATABASE_URLs
    there; sync all copies of common.py across the repo
    - api_wwcs.py: import connection settings from common; replace
    hardcoded WWCServices schema in /areas and /planting/jamoat queries
    with SERVICES_SCHEMA
    - api_station.py: import DATABASE_URL_MACHINES and ENV from common
    instead of constructing them locally
    - api_wwcs.py: fix /planting and /harvest parameter validation, which
    referenced the Python builtins id/type and only ever checked date
    - test_api_station.py: send a valid signature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
2026-09-23 API airquality tests: set received explicitly on inserted observations
    MachineObs.received has no default on every deployment, so the test
    helper must provide it.
2026-09-28 API airquality: identify the stations by their PM2.5 data
    The "_ECO" suffix of the siteID only holds in Tajikistan. Follow the logic
    of the shiny apps (WWCS/airq_map/app.R) instead: a station is a site of type
    WWCS whose logger delivers PM2.5.
    The set is resolved in two indexed steps — the loggers currently deployed at
    WWCS sites, then the ones among them that reported PM2.5 within the lookback
    window — so no query scans MachineObs as a whole.
    Unlike the shiny apps, which look at the very last record of each logger, the
    window keeps a station listed while it is silent or while its PM sensor is
    broken: the portal then shows it as offline with its last PM2.5 reading,
    instead of dropping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
2026-09-28 koala04: added error code for failing server connect to signalStrength
    [FirmwareKoala_rev4.0.ino]
2026-10-06 updated assembly manual
2026-10-26 API airquality: drop stations whose last PM2.5 reading is stale
    A station that saturated its PM sensor and then went silent kept its last
    reading on the portal for a week: the Hydromet office showed 561 ug/m3 and
    AQI 500 from 20 October, six days after it stopped reporting.
    The stations report every ten minutes, so a day-old measurement is not the
    air quality of right now. Narrow the window that decides which sites are air
    quality stations from seven days to 24 hours: a short outage still leaves the
    station listed, shown as offline with its last reading, while one that is
    silent for longer drops out and comes back on its own once it reports again.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
2026-10-30 nginx: mirror /post/ station ingestion to wwcs-core
    During the coexistence phase every station request to /post/ is mirrored
    to wwcs-core's gunicorn socket, so MariaDB and PostgreSQL receive the
    same rows while the old and new systems run in parallel. The mirrored
    copy is fire-and-forget: the logger only sees the legacy api_station
    response, and mirror failures land in the nginx error log. Applies to
    both the HTTPS and the plain-HTTP /post/ blocks, since some loggers
    post without TLS.
    The rewrite targets /core/api/<x> because gunicorn strips the /core
    prefix (SCRIPT_NAME=/core in wwcs-core/.env) before Django sees the
    request, and rejects paths that do not start with it. The station
    signatu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
2026-10-30 nginx: fix mirror of /post/ ingestion to wwcs-core
    A mirror subrequest goes to the literal URI given in the `mirror`
    directive; a named location (@wwcs_core) is never entered — nginx fell
    through to static file serving, the subrequest died with a silent 404,
    and mirrored inserts never reached wwcs-core's gunicorn socket.
    Mirror to an internal prefix location instead and rebuild the target
    URI there from $request_uri, passed to the gunicorn socket via a
    variable proxy_pass as /core/api/<x>.
